AshenKavinda/Robotic_Arduino/Gallery/IMG-20250606-WA0005.jpg

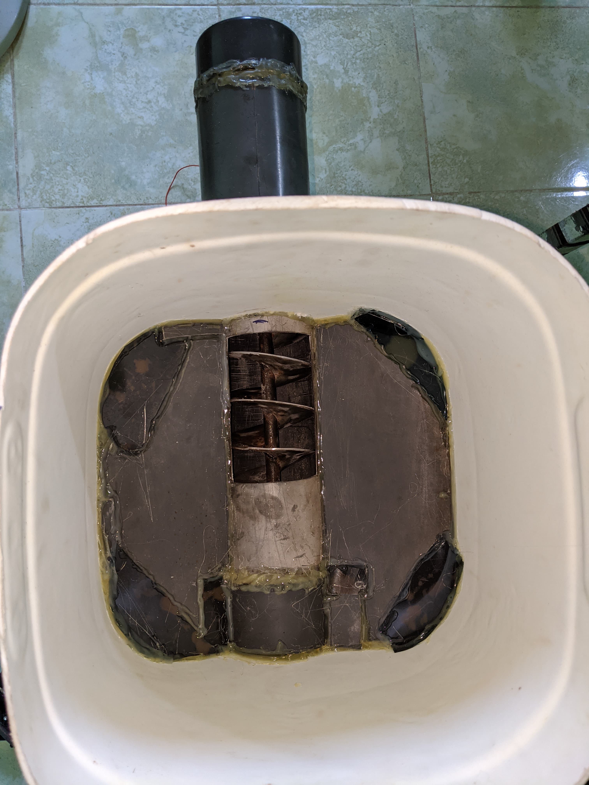
Gallery/IMG-20250606-WA0005.jpg
