AshenKavinda/Robotic_Arduino/README.md

<body>

  <h1>Automated Measuring and Dispensing System</h1>

  <p><strong>Author:</strong> Hemarathna H. A. A. K<br>
  <strong>Institution:</strong> NIBM Galle</p>

  <h2>📌 Project Overview</h2>
  <p>
    This project is an <strong>automated self-service dispensing system</strong> developed as part of a robotics module
    in a Higher Diploma program. It enables supermarket customers to independently measure and collect dry commodities 
    (e.g., rice, dhal, flour) without staff assistance. The system features:
  </p>
  <ul>
    <li>Accurate weighing using 4 × 50kg load cells and HX711 module</li>
    <li>Controlled dispensing via Archimedes screw driven by a gear motor</li>
    <li>Arduino Uno-based control logic</li>
    <li>User interface with a 4×3 keypad and 16×2 I2C LCD display</li>
    <li>Smart logic to slow down motor near the final weight for better precision</li>
  </ul>

  <h2>📂 Repository Structure</h2>
  <ul>
    <li><code>Arduino_Code/</code> – Arduino source code for the project</li>
    <li><code>Research_Paper.pdf</code> – Full documentation of the research, design, and methodology</li>
    <li><code>Gallery/</code> – In-progress build and testing photos 📸</li>
  </ul>

  <p>➡️ <strong>Check out the <code>Gallery</code> directory to see in-progress development photos and hardware implementation!</strong></p>

  <h2>🎯 Objectives</h2>
  <ul>
    <li>Improve bulk product dispensing efficiency in supermarkets</li>
    <li>Provide a simple, scalable, and user-friendly interface</li>
    <li>Reduce labor costs and human error in measurement</li>
  </ul>

  <h2>🔧 Key Technologies & Components</h2>
  <ul>
    <li>Arduino Uno</li>
    <li>Archimedes screw + 100 RPM Gear Motor</li>
    <li>L298N Motor Driver</li>
    <li>HX711 Load Cell Amplifier</li>
    <li>4x3 Keypad</li>
    <li>16x2 LCD with I2C Interface</li>
  </ul>

  <h2>🧪 Testing & Results</h2>
  <p>
    Several technical challenges such as motor torque issues, load cell accuracy, and voltage inconsistencies were solved during implementation. 
    Smart control logic was developed to enhance measurement precision and system stability.
  </p>

  <h2>📎 Resources</h2>
  <ul>
    <li><a href="https://docs.google.com/document/d/1DaOAFT8bQvEzSwUqmQyisoYYA060ICEjH8NpNxVbs-0/edit?usp=sharing" target="_blank">Project Budget</a></li>
    <li><a href="https://app.cirkitdesigner.com/project/1ef32f10-1c7f-408f-af8e-330d7ac19076" target="_blank">Circuit Diagram</a></li>
  </ul>

  <hr>

  <p>📖 <em>This research was completed as part of the Robotics Module at NIBM. Special thanks to the supervising staff and colleagues for their support.</em></p>

</body>
