AshenKavinda/Robotic_Arduino/Gallery/IMG-20250606-WA0004.jpg

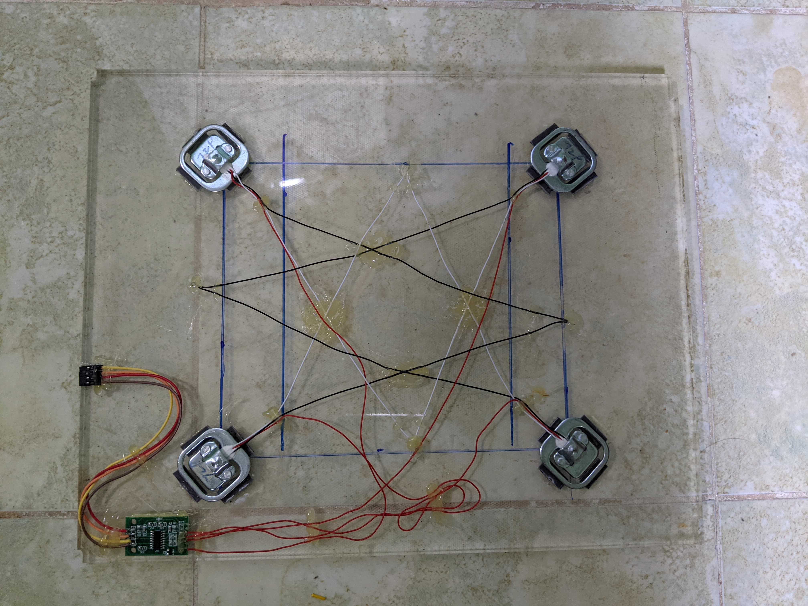
Gallery/IMG-20250606-WA0004.jpg
