AshenKavinda/Robotic_Arduino/Gallery/IMG-20250606-WA0011.jpg

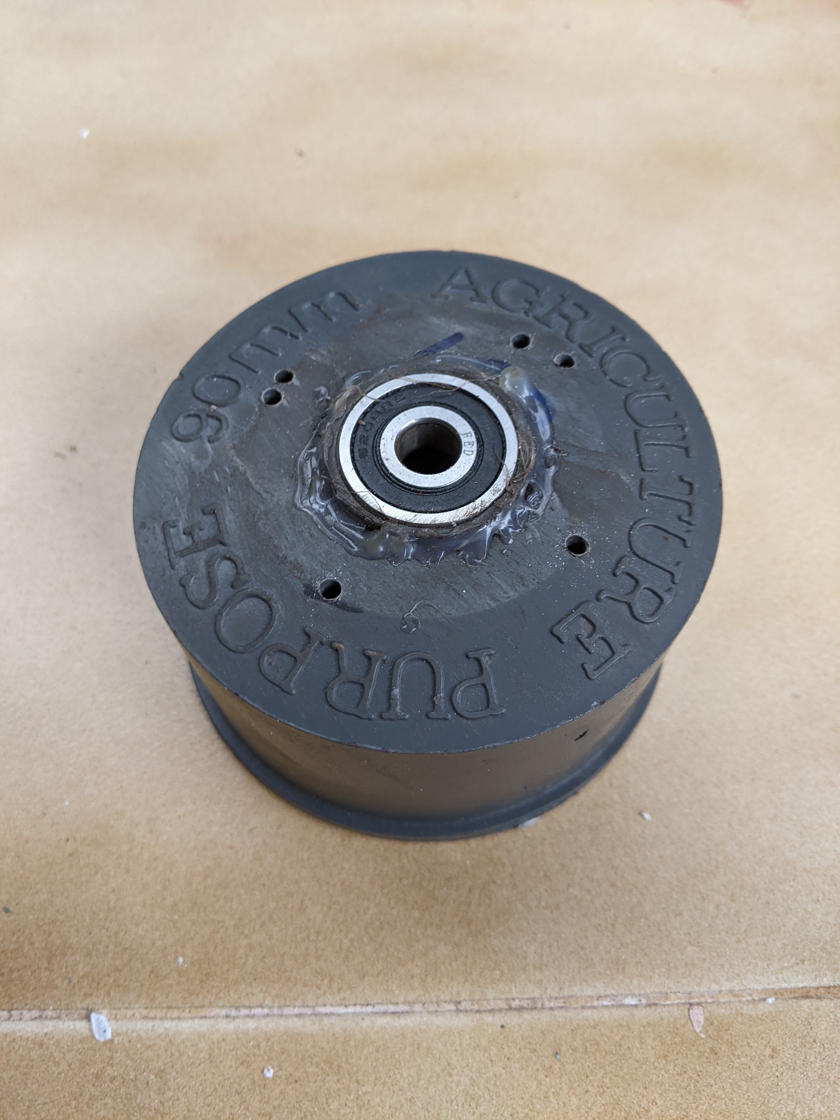
Gallery/IMG-20250606-WA0011.jpg
